listofoptions/Z80-cpu-interposer/nabu processor interposer.kicad_pcb

## KiCad design nabu processor interposer.kicad_pcb (2022-12-26)

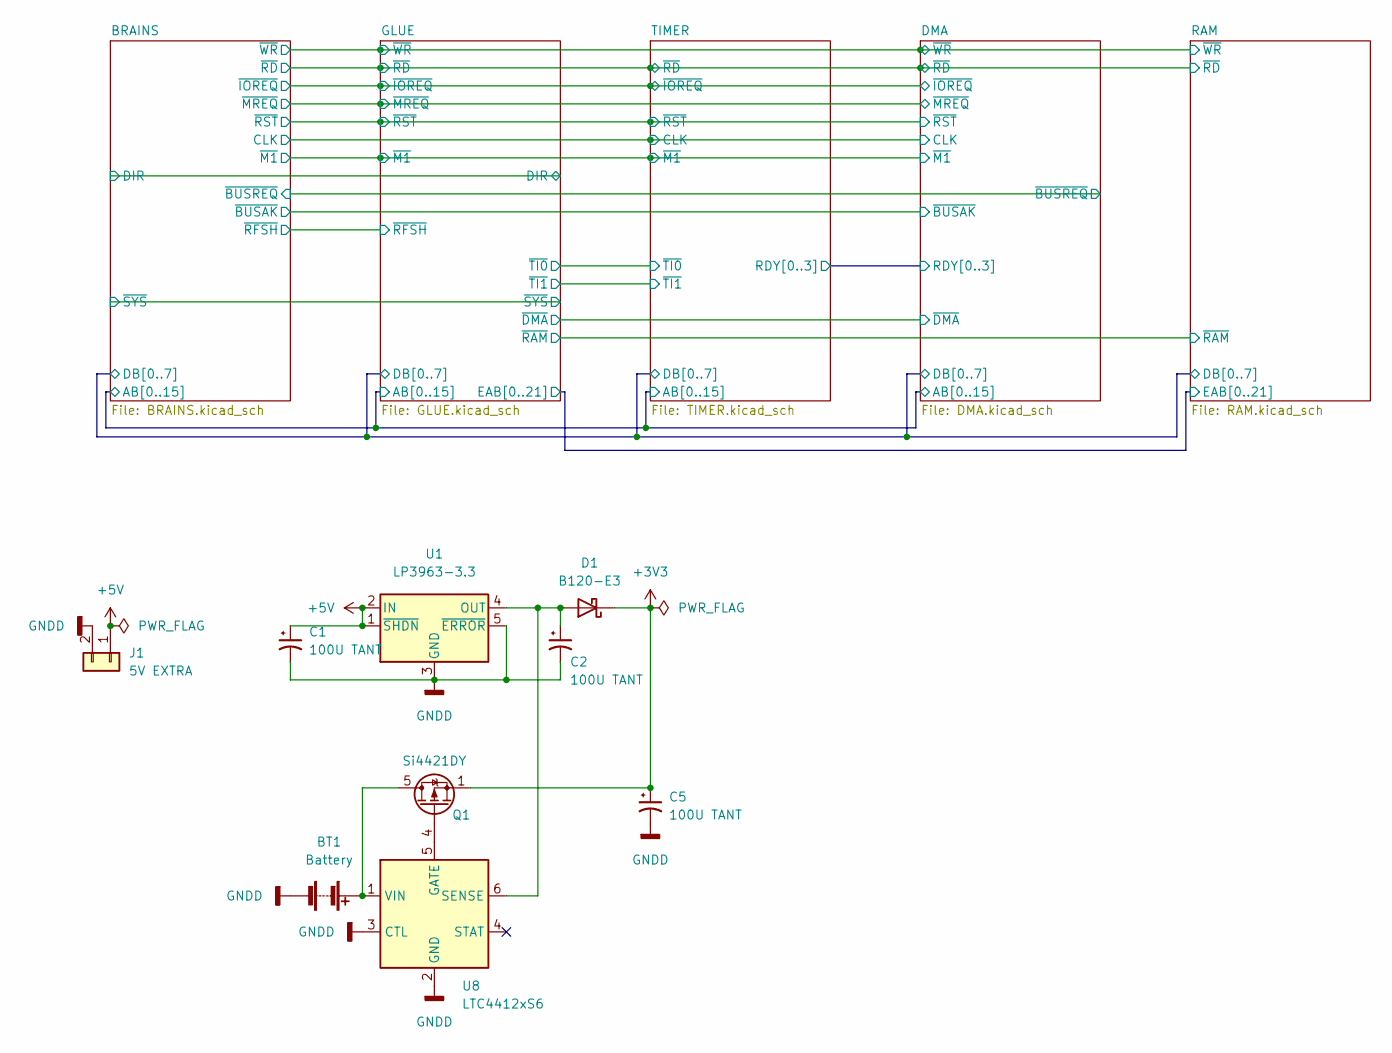
[picture p1: schematic nabu processor interposer.kicad_sch, Z80 CPU INTERPOSER]

Parts:
BT1: Battery; BatteryHolder_Keystone_2462_2xAA
C1, C2, C5: 100U TANT; CP_EIA-3528-15_AVX-H
D1: B120-E3; D_SMA
J1: 5V EXTRA; PinHeader_1x02_P2.54mm_Vertical
Q1: Si4421DY; SO-8_3.9x4.9mm_P1.27mm
U1: LP3963-3.3; TO-263-5_TabPin3
U8: LTC4412xS6; TSOT-23-6

Connections:
+3V3: C5.1, D1.1 (K), Q1.1 (S), Q1.2, Q1.3; also elsewhere on the board
+5V: C1.1, J1.1, U1.1 (~SHDN), U1.2 (IN); also elsewhere on the board
GND: BT1.2 (-), C1.2, C2.2, C5.2, J1.2, U1.3 (GND), U1.5 (~ERROR), U8.2 (GND), U8.3 (CTL); also elsewhere on the board
unnamed: BT1.1 (+), Q1.5 (D), Q1.6, Q1.7, Q1.8, U8.1 (VIN)
unnamed: C2.1, D1.2 (A), U1.4 (OUT), U8.6 (SENSE)
unnamed: Q1.4 (G), U8.5 (GATE)

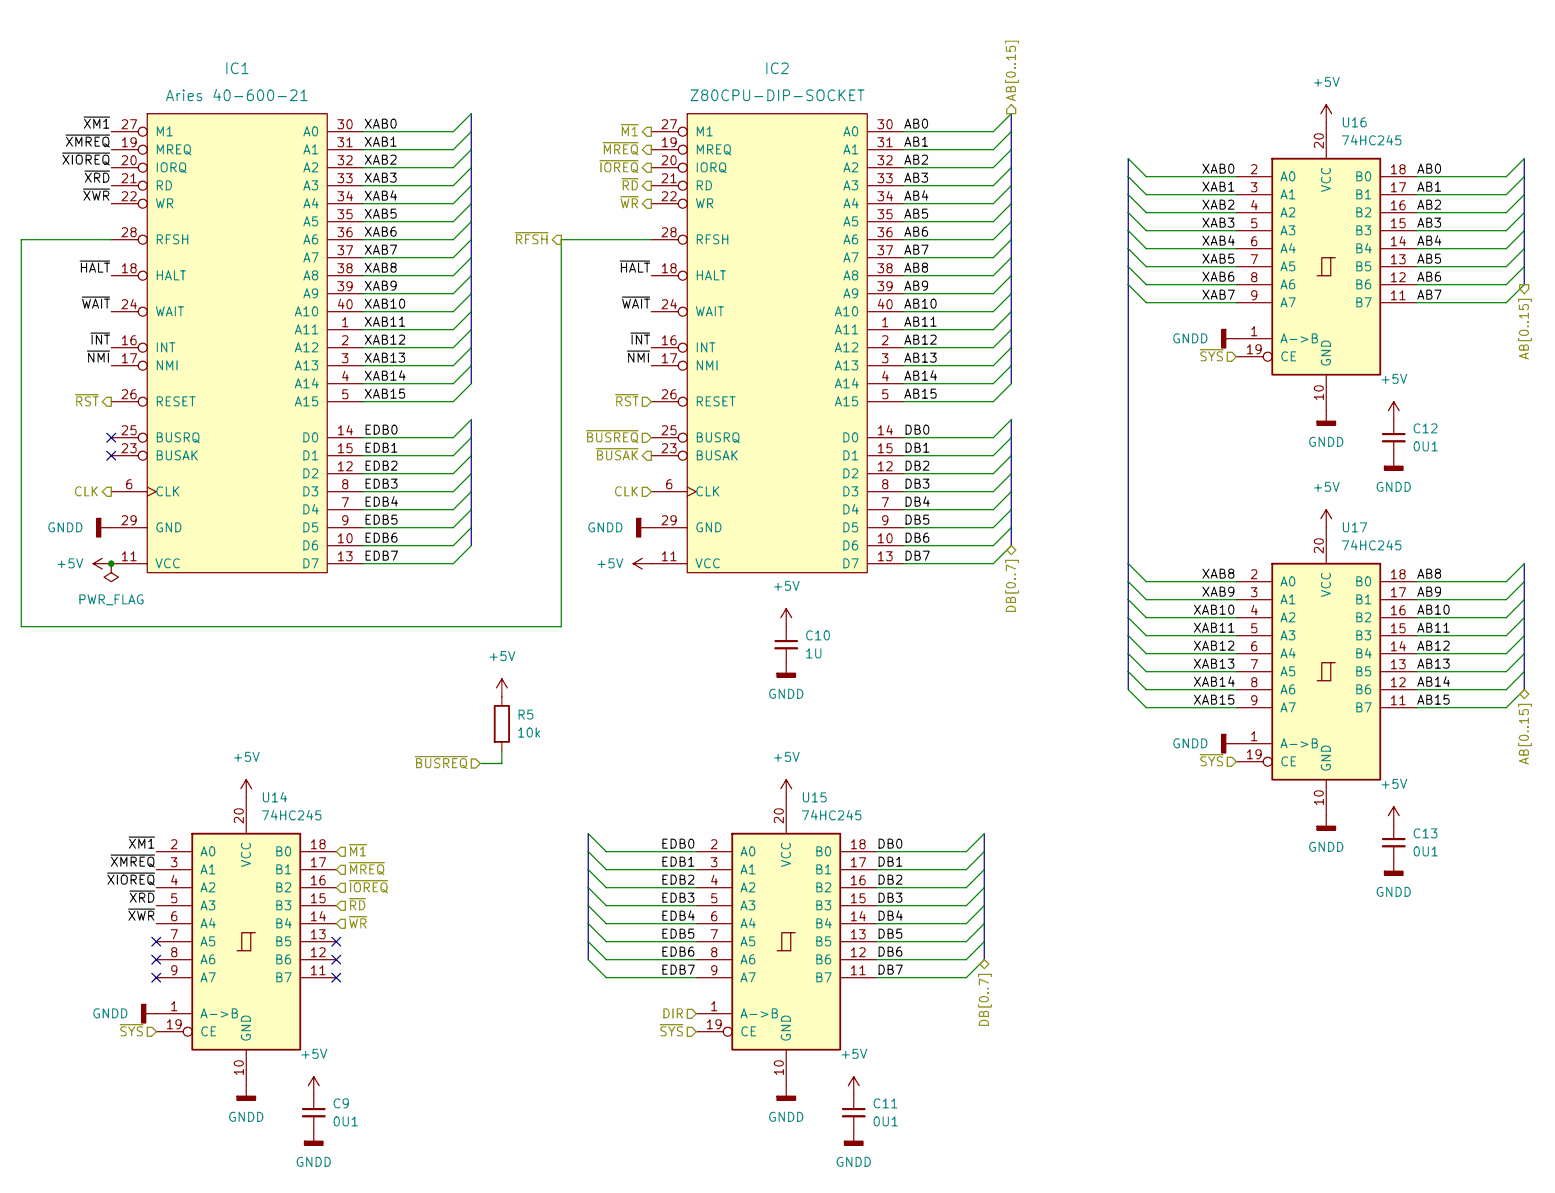
[picture p2: schematic BRAINS.kicad_sch, Z80 CPU INTERPOSER CPU AND PIN CONNECTOR]

Parts:
C9, C11, C12, C13: 0U1; C_1206_3216Metric
C10: 1U; C_1206_3216Metric
IC1: Aries 40-600-21; DIP-40_W15.24mm_Socket
IC2: Z80CPU-DIP-SOCKET; DIP-40_W15.24mm_Socket
R5: 10k; R_0603_1608Metric
U14, U15, U16, U17: 74HC245; TSSOP-20_4.4x6.5mm_P0.65mm

Connections:
+5V: C9.1, C10.1, C11.1, C12.1, C13.1, IC1.11 (VCC), IC2.11 (VCC), R5.1, U14.20 (VCC), U15.20 (VCC), U16.20 (VCC), U17.20 (VCC); also elsewhere on the board
/BRAINS/AB0: IC2.30 (A0), U16.18 (B0); also elsewhere on the board
/BRAINS/AB1: IC2.31 (A1), U16.17 (B1); also elsewhere on the board
/BRAINS/AB2: IC2.32 (A2), U16.16 (B2); also elsewhere on the board
/BRAINS/AB3: IC2.33 (A3), U16.15 (B3); also elsewhere on the board
/BRAINS/AB4: IC2.34 (A4), U16.14 (B4); also elsewhere on the board
/BRAINS/AB5: IC2.35 (A5), U16.13 (B5); also elsewhere on the board
/BRAINS/AB6: IC2.36 (A6), U16.12 (B6); also elsewhere on the board
/BRAINS/AB7: IC2.37 (A7), U16.11 (B7); also elsewhere on the board
/BRAINS/AB8: IC2.38 (A8), U17.18 (B0); also elsewhere on the board
/BRAINS/AB9: IC2.39 (A9), U17.17 (B1); also elsewhere on the board
/BRAINS/AB10: IC2.40 (A10), U17.16 (B2); also elsewhere on the board
/BRAINS/AB11: IC2.1 (A11), U17.15 (B3); also elsewhere on the board
/BRAINS/AB12: IC2.2 (A12), U17.14 (B4); also elsewhere on the board
/BRAINS/AB13: IC2.3 (A13), U17.13 (B5); also elsewhere on the board
/BRAINS/AB14: IC2.4 (A14), U17.12 (B6); also elsewhere on the board
/BRAINS/AB15: IC2.5 (A15), U17.11 (B7); also elsewhere on the board
/BRAINS/CLK: IC1.6 (CLK), IC2.6 (CLK); also elsewhere on the board
/BRAINS/DB0: IC2.14 (D0), U15.18 (B0); also elsewhere on the board
/BRAINS/DB1: IC2.15 (D1), U15.17 (B1); also elsewhere on the board
/BRAINS/DB2: IC2.12 (D2), U15.16 (B2); also elsewhere on the board
/BRAINS/DB3: IC2.8 (D3), U15.15 (B3); also elsewhere on the board
/BRAINS/DB4: IC2.7 (D4), U15.14 (B4); also elsewhere on the board
/BRAINS/DB5: IC2.9 (D5), U15.13 (B5); also elsewhere on the board
/BRAINS/DB6: IC2.10 (D6), U15.12 (B6); also elsewhere on the board
/BRAINS/DB7: IC2.13 (D7), U15.11 (B7); also elsewhere on the board
/BRAINS/DIR: U15.1 (A->B); also elsewhere on the board
/BRAINS/EDB0: IC1.14 (D0), U15.2 (A0)
/BRAINS/EDB1: IC1.15 (D1), U15.3 (A1)
/BRAINS/EDB2: IC1.12 (D2), U15.4 (A2)
/BRAINS/EDB3: IC1.8 (D3), U15.5 (A3)
/BRAINS/EDB4: IC1.7 (D4), U15.6 (A4)
/BRAINS/EDB5: IC1.9 (D5), U15.7 (A5)
/BRAINS/EDB6: IC1.10 (D6), U15.8 (A6)
/BRAINS/EDB7: IC1.13 (D7), U15.9 (A7)
/BRAINS/XAB0: IC1.30 (A0), U16.2 (A0)
/BRAINS/XAB1: IC1.31 (A1), U16.3 (A1)
/BRAINS/XAB2: IC1.32 (A2), U16.4 (A2)
/BRAINS/XAB3: IC1.33 (A3), U16.5 (A3)
/BRAINS/XAB4: IC1.34 (A4), U16.6 (A4)
/BRAINS/XAB5: IC1.35 (A5), U16.7 (A5)
/BRAINS/XAB6: IC1.36 (A6), U16.8 (A6)
/BRAINS/XAB7: IC1.37 (A7), U16.9 (A7)
/BRAINS/XAB8: IC1.38 (A8), U17.2 (A0)
/BRAINS/XAB9: IC1.39 (A9), U17.3 (A1)
/BRAINS/XAB10: IC1.40 (A10), U17.4 (A2)
/BRAINS/XAB11: IC1.1 (A11), U17.5 (A3)
/BRAINS/XAB12: IC1.2 (A12), U17.6 (A4)
/BRAINS/XAB13: IC1.3 (A13), U17.7 (A5)
/BRAINS/XAB14: IC1.4 (A14), U17.8 (A6)
/BRAINS/XAB15: IC1.5 (A15), U17.9 (A7)
/BRAINS/~BUSAK: IC2.23 (BUSAK); also elsewhere on the board
/BRAINS/~BUSREQ: IC2.25 (BUSRQ), R5.2; also elsewhere on the board
/BRAINS/~HALT: IC1.18 (HALT), IC2.18 (HALT)
/BRAINS/~INT: IC1.16 (INT), IC2.16 (INT)
/BRAINS/~IOREQ: IC2.20 (IORQ), U14.16 (B2); also elsewhere on the board
/BRAINS/~M1: IC2.27 (M1), U14.18 (B0); also elsewhere on the board
/BRAINS/~MREQ: IC2.19 (MREQ), U14.17 (B1); also elsewhere on the board
/BRAINS/~NMI: IC1.17 (NMI), IC2.17 (NMI)
/BRAINS/~RD: IC2.21 (RD), U14.15 (B3); also elsewhere on the board
/BRAINS/~RFSH: IC1.28 (RFSH), IC2.28 (RFSH); also elsewhere on the board
/BRAINS/~RST: IC1.26 (RESET), IC2.26 (RESET); also elsewhere on the board
/BRAINS/~SYS: U14.19 (CE), U15.19 (CE), U16.19 (CE), U17.19 (CE); also elsewhere on the board
/BRAINS/~WAIT: IC1.24 (WAIT), IC2.24 (WAIT)
/BRAINS/~WR: IC2.22 (WR), U14.14 (B4); also elsewhere on the board
/BRAINS/~XIOREQ: IC1.20 (IORQ), U14.4 (A2)
/BRAINS/~XM1: IC1.27 (M1), U14.2 (A0)
/BRAINS/~XMREQ: IC1.19 (MREQ), U14.3 (A1)
/BRAINS/~XRD: IC1.21 (RD), U14.5 (A3)
/BRAINS/~XWR: IC1.22 (WR), U14.6 (A4)
GND: C9.2, C10.2, C11.2, C12.2, C13.2, IC1.29 (GND), IC2.29 (GND), U14.1 (A->B), U14.10 (GND), U15.10 (GND), U16.1 (A->B), U16.10 (GND), U17.1 (A->B), U17.10 (GND); also elsewhere on the board

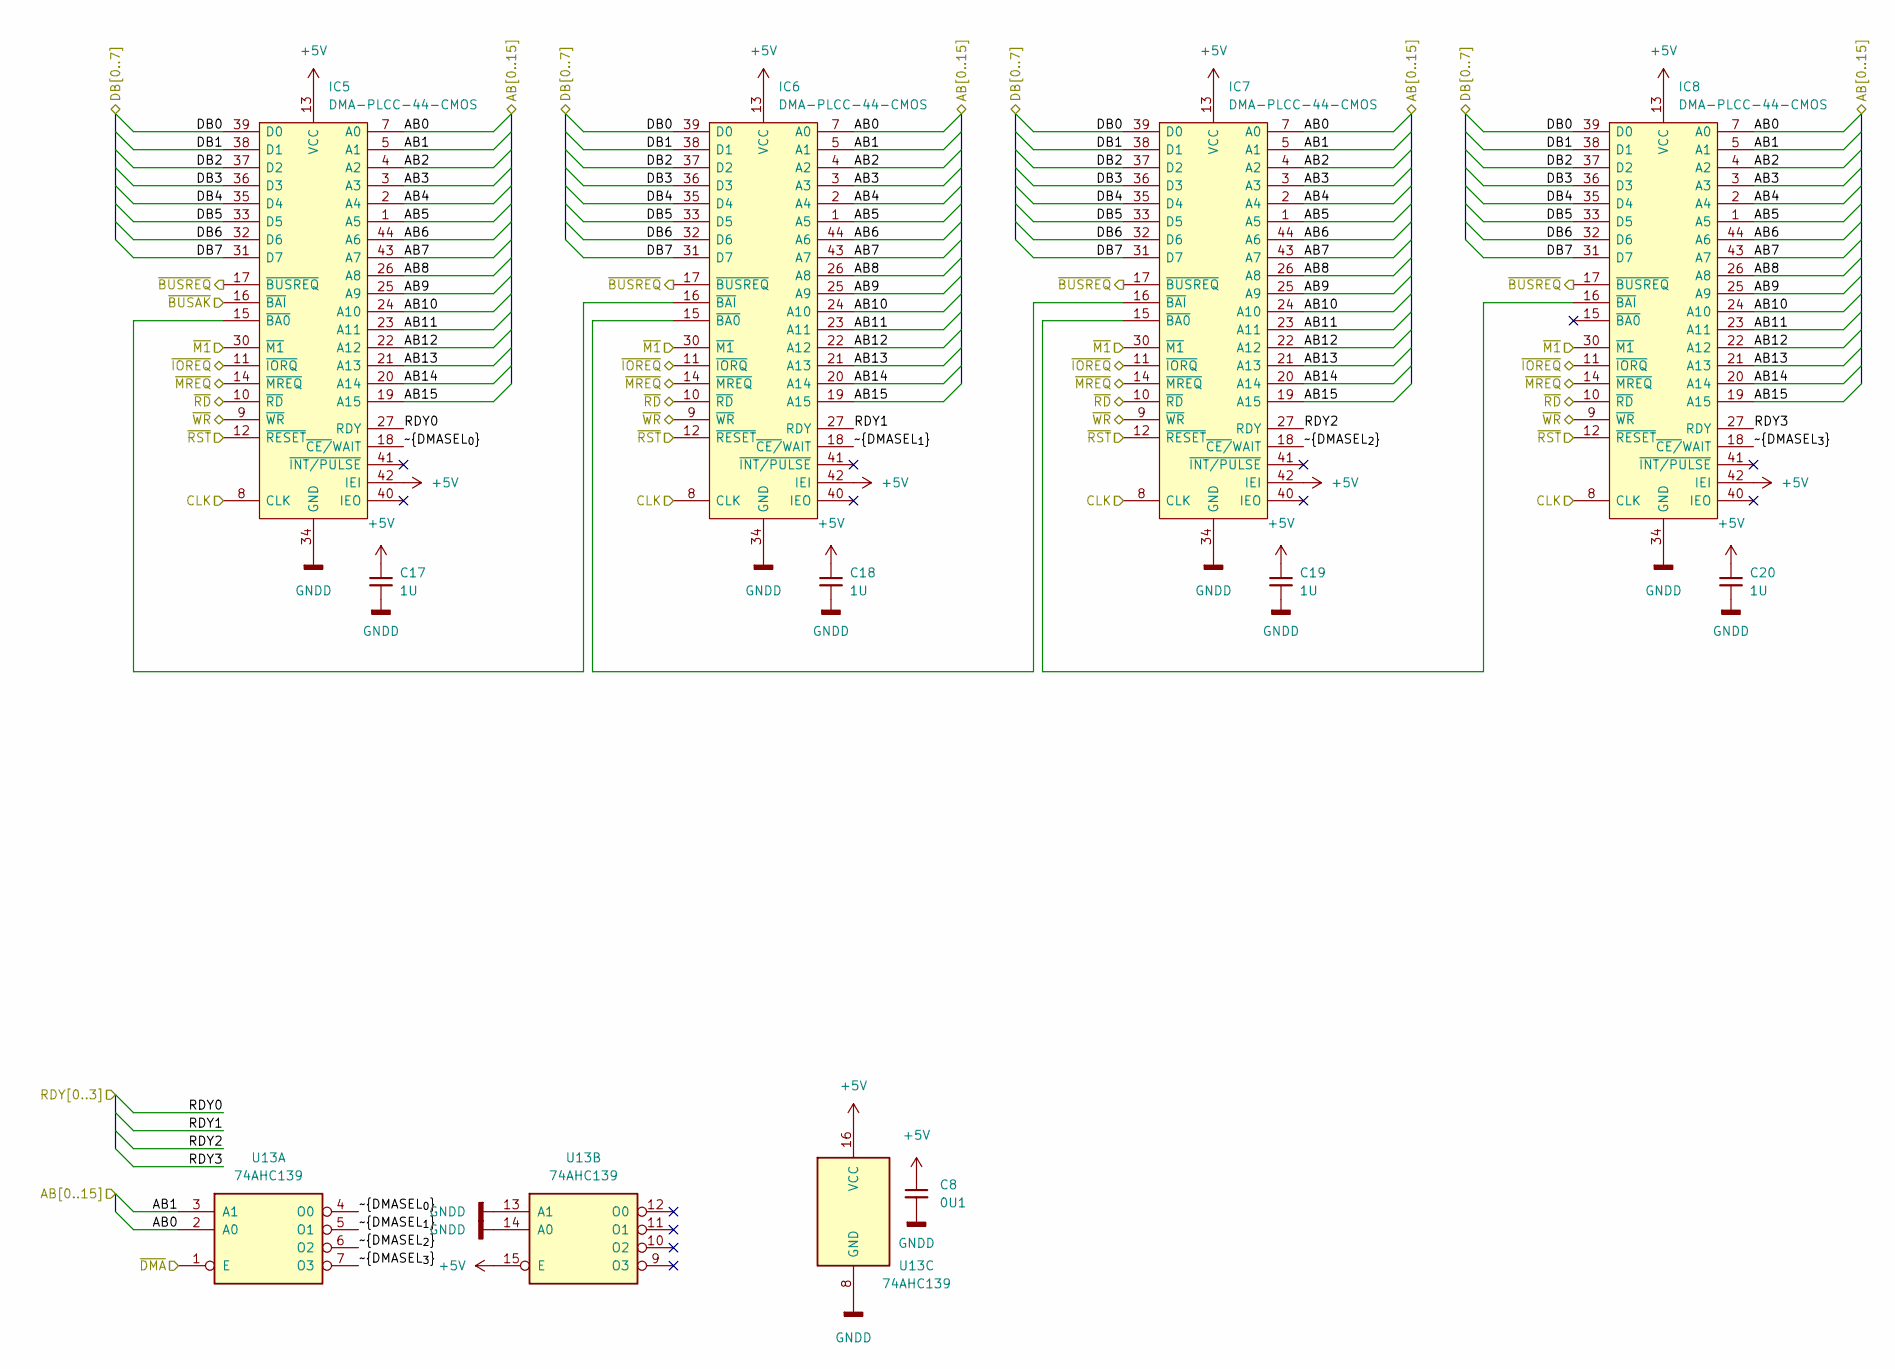
[picture p3: schematic DMA.kicad_sch, Z80 CPU INTERPOSER DMA AND DMA CONTROL]

Parts:
C8: 0U1; C_0603_1608Metric
C17, C18, C19, C20: 1U; C_1206_3216Metric
IC5, IC6, IC7, IC8: DMA-PLCC-44-CMOS; LQFP-44_10x10mm_P0.8mm; Manufacturer_Part_Number Z84C4206PEG; Mouser Part Number 692-Z84C4206PEG
U13: 74AHC139; TSSOP-16_4.4x5mm_P0.65mm

Connections:
+5V: C8.1, C17.1, C18.1, C19.1, C20.1, IC5.13 (VCC), IC5.42 (IEI), IC6.13 (VCC), IC6.42 (IEI), IC7.13 (VCC), IC7.42 (IEI), IC8.13 (VCC), IC8.42 (IEI), U13.15 (E), U13.16 (VCC); also elsewhere on the board
/BRAINS/AB0: IC5.7 (A0), IC6.7 (A0), IC7.7 (A0), IC8.7 (A0), U13.2 (A0); also elsewhere on the board
/BRAINS/AB1: IC5.5 (A1), IC6.5 (A1), IC7.5 (A1), IC8.5 (A1), U13.3 (A1); also elsewhere on the board
/BRAINS/AB2: IC5.4 (A2), IC6.4 (A2), IC7.4 (A2), IC8.4 (A2); also elsewhere on the board
/BRAINS/AB3: IC5.3 (A3), IC6.3 (A3), IC7.3 (A3), IC8.3 (A3); also elsewhere on the board
/BRAINS/AB4: IC5.2 (A4), IC6.2 (A4), IC7.2 (A4), IC8.2 (A4); also elsewhere on the board
/BRAINS/AB5: IC5.1 (A5), IC6.1 (A5), IC7.1 (A5), IC8.1 (A5); also elsewhere on the board
/BRAINS/AB6: IC5.44 (A6), IC6.44 (A6), IC7.44 (A6), IC8.44 (A6); also elsewhere on the board
/BRAINS/AB7: IC5.43 (A7), IC6.43 (A7), IC7.43 (A7), IC8.43 (A7); also elsewhere on the board
/BRAINS/AB8: IC5.26 (A8), IC6.26 (A8), IC7.26 (A8), IC8.26 (A8); also elsewhere on the board
/BRAINS/AB9: IC5.25 (A9), IC6.25 (A9), IC7.25 (A9), IC8.25 (A9); also elsewhere on the board
/BRAINS/AB10: IC5.24 (A10), IC6.24 (A10), IC7.24 (A10), IC8.24 (A10); also elsewhere on the board
/BRAINS/AB11: IC5.23 (A11), IC6.23 (A11), IC7.23 (A11), IC8.23 (A11); also elsewhere on the board
/BRAINS/AB12: IC5.22 (A12), IC6.22 (A12), IC7.22 (A12), IC8.22 (A12); also elsewhere on the board
/BRAINS/AB13: IC5.21 (A13), IC6.21 (A13), IC7.21 (A13), IC8.21 (A13); also elsewhere on the board
/BRAINS/AB14: IC5.20 (A14), IC6.20 (A14), IC7.20 (A14), IC8.20 (A14); also elsewhere on the board
/BRAINS/AB15: IC5.19 (A15), IC6.19 (A15), IC7.19 (A15), IC8.19 (A15); also elsewhere on the board
/BRAINS/CLK: IC5.8 (CLK), IC6.8 (CLK), IC7.8 (CLK), IC8.8 (CLK); also elsewhere on the board
/BRAINS/DB0: IC5.39 (D0), IC6.39 (D0), IC7.39 (D0), IC8.39 (D0); also elsewhere on the board
/BRAINS/DB1: IC5.38 (D1), IC6.38 (D1), IC7.38 (D1), IC8.38 (D1); also elsewhere on the board
/BRAINS/DB2: IC5.37 (D2), IC6.37 (D2), IC7.37 (D2), IC8.37 (D2); also elsewhere on the board
/BRAINS/DB3: IC5.36 (D3), IC6.36 (D3), IC7.36 (D3), IC8.36 (D3); also elsewhere on the board
/BRAINS/DB4: IC5.35 (D4), IC6.35 (D4), IC7.35 (D4), IC8.35 (D4); also elsewhere on the board
/BRAINS/DB5: IC5.33 (D5), IC6.33 (D5), IC7.33 (D5), IC8.33 (D5); also elsewhere on the board
/BRAINS/DB6: IC5.32 (D6), IC6.32 (D6), IC7.32 (D6), IC8.32 (D6); also elsewhere on the board
/BRAINS/DB7: IC5.31 (D7), IC6.31 (D7), IC7.31 (D7), IC8.31 (D7); also elsewhere on the board
/BRAINS/~BUSAK: IC5.16 (~BAI); also elsewhere on the board
/BRAINS/~BUSREQ: IC5.17 (~BUSREQ), IC6.17 (~BUSREQ), IC7.17 (~BUSREQ), IC8.17 (~BUSREQ); also elsewhere on the board
/BRAINS/~IOREQ: IC5.11 (~IORQ), IC6.11 (~IORQ), IC7.11 (~IORQ), IC8.11 (~IORQ); also elsewhere on the board
/BRAINS/~M1: IC5.30 (~M1), IC6.30 (~M1), IC7.30 (~M1), IC8.30 (~M1); also elsewhere on the board
/BRAINS/~MREQ: IC5.14 (~MREQ), IC6.14 (~MREQ), IC7.14 (~MREQ), IC8.14 (~MREQ); also elsewhere on the board
/BRAINS/~RD: IC5.10 (~RD), IC6.10 (~RD), IC7.10 (~RD), IC8.10 (~RD); also elsewhere on the board
/BRAINS/~RST: IC5.12 (~RESET), IC6.12 (~RESET), IC7.12 (~RESET), IC8.12 (~RESET); also elsewhere on the board
/BRAINS/~WR: IC5.9 (~WR), IC6.9 (~WR), IC7.9 (~WR), IC8.9 (~WR); also elsewhere on the board
/DMA/RDY0: IC5.27 (RDY); also elsewhere on the board
/DMA/RDY1: IC6.27 (RDY); also elsewhere on the board
/DMA/RDY2: IC7.27 (RDY); also elsewhere on the board
/DMA/RDY3: IC8.27 (RDY); also elsewhere on the board
/DMA/~DMASEL_{0}: IC5.18 (~CE/WAIT), U13.4 (O0)
/DMA/~DMASEL_{1}: IC6.18 (~CE/WAIT), U13.5 (O1)
/DMA/~DMASEL_{2}: IC7.18 (~CE/WAIT), U13.6 (O2)
/DMA/~DMASEL_{3}: IC8.18 (~CE/WAIT), U13.7 (O3)
/DMA/~DMA: U13.1 (E); also elsewhere on the board
GND: C8.2, C17.2, C18.2, C19.2, C20.2, IC5.34 (GND), IC6.34 (GND), IC7.34 (GND), IC8.34 (GND), U13.8 (GND), U13.13 (A1), U13.14 (A0); also elsewhere on the board
unnamed: IC5.15 (~BA0), IC6.16 (~BAI)
unnamed: IC6.15 (~BA0), IC7.16 (~BAI)
unnamed: IC7.15 (~BA0), IC8.16 (~BAI)

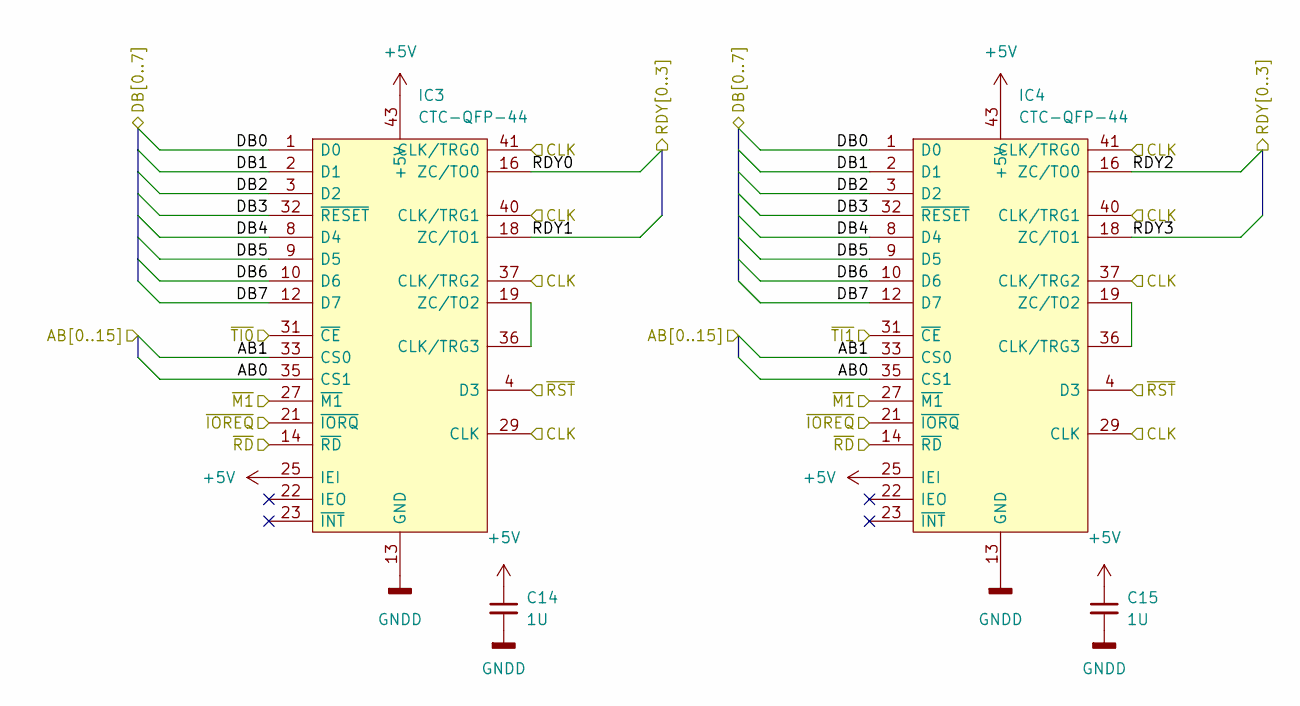
[picture p4: schematic TIMER.kicad_sch, Z80 CPU INTERPOSER DMA AND DMA CONTROL]

Parts:
C14, C15: 1U; C_1206_3216Metric
IC3, IC4: CTC-QFP-44; LQFP-44_10x10mm_P0.8mm; Manufacturer_Part_Number Z84C3010PEG; Mouser Part Number 692-Z84C3010PEG

Connections:
+5V: C14.1, C15.1, IC3.25 (IEI), IC3.43 (+5V), IC4.25 (IEI), IC4.43 (+5V); also elsewhere on the board
/BRAINS/AB0: IC3.35 (CS1), IC4.35 (CS1); also elsewhere on the board
/BRAINS/AB1: IC3.33 (CS0), IC4.33 (CS0); also elsewhere on the board
/BRAINS/CLK: IC3.29 (CLK), IC3.37 (CLK/TRG2), IC3.40 (CLK/TRG1), IC3.41 (CLK/TRG0), IC4.29 (CLK), IC4.37 (CLK/TRG2), IC4.40 (CLK/TRG1), IC4.41 (CLK/TRG0); also elsewhere on the board
/BRAINS/DB0: IC3.1 (D0), IC4.1 (D0); also elsewhere on the board
/BRAINS/DB1: IC3.2 (D1), IC4.2 (D1); also elsewhere on the board
/BRAINS/DB2: IC3.3 (D2), IC4.3 (D2); also elsewhere on the board
/BRAINS/DB3: IC3.32 (~RESET), IC4.32 (~RESET); also elsewhere on the board
/BRAINS/DB4: IC3.8 (D4), IC4.8 (D4); also elsewhere on the board
/BRAINS/DB5: IC3.9 (D5), IC4.9 (D5); also elsewhere on the board
/BRAINS/DB6: IC3.10 (D6), IC4.10 (D6); also elsewhere on the board
/BRAINS/DB7: IC3.12 (D7), IC4.12 (D7); also elsewhere on the board
/BRAINS/~IOREQ: IC3.21 (~IORQ), IC4.21 (~IORQ); also elsewhere on the board
/BRAINS/~M1: IC3.27 (~M1), IC4.27 (~M1); also elsewhere on the board
/BRAINS/~RD: IC3.14 (~RD), IC4.14 (~RD); also elsewhere on the board
/BRAINS/~RST: IC3.4 (D3), IC4.4 (D3); also elsewhere on the board
/DMA/RDY0: IC3.16 (ZC/TO0); also elsewhere on the board
/DMA/RDY1: IC3.18 (ZC/TO1); also elsewhere on the board
/DMA/RDY2: IC4.16 (ZC/TO0); also elsewhere on the board
/DMA/RDY3: IC4.18 (ZC/TO1); also elsewhere on the board
/GLUE/~TI0: IC3.31 (~CE); also elsewhere on the board
/GLUE/~TI1: IC4.31 (~CE); also elsewhere on the board
GND: C14.2, C15.2, IC3.13 (GND), IC4.13 (GND); also elsewhere on the board
unnamed: IC3.19 (ZC/TO2), IC3.36 (CLK/TRG3)
unnamed: IC4.19 (ZC/TO2), IC4.36 (CLK/TRG3)

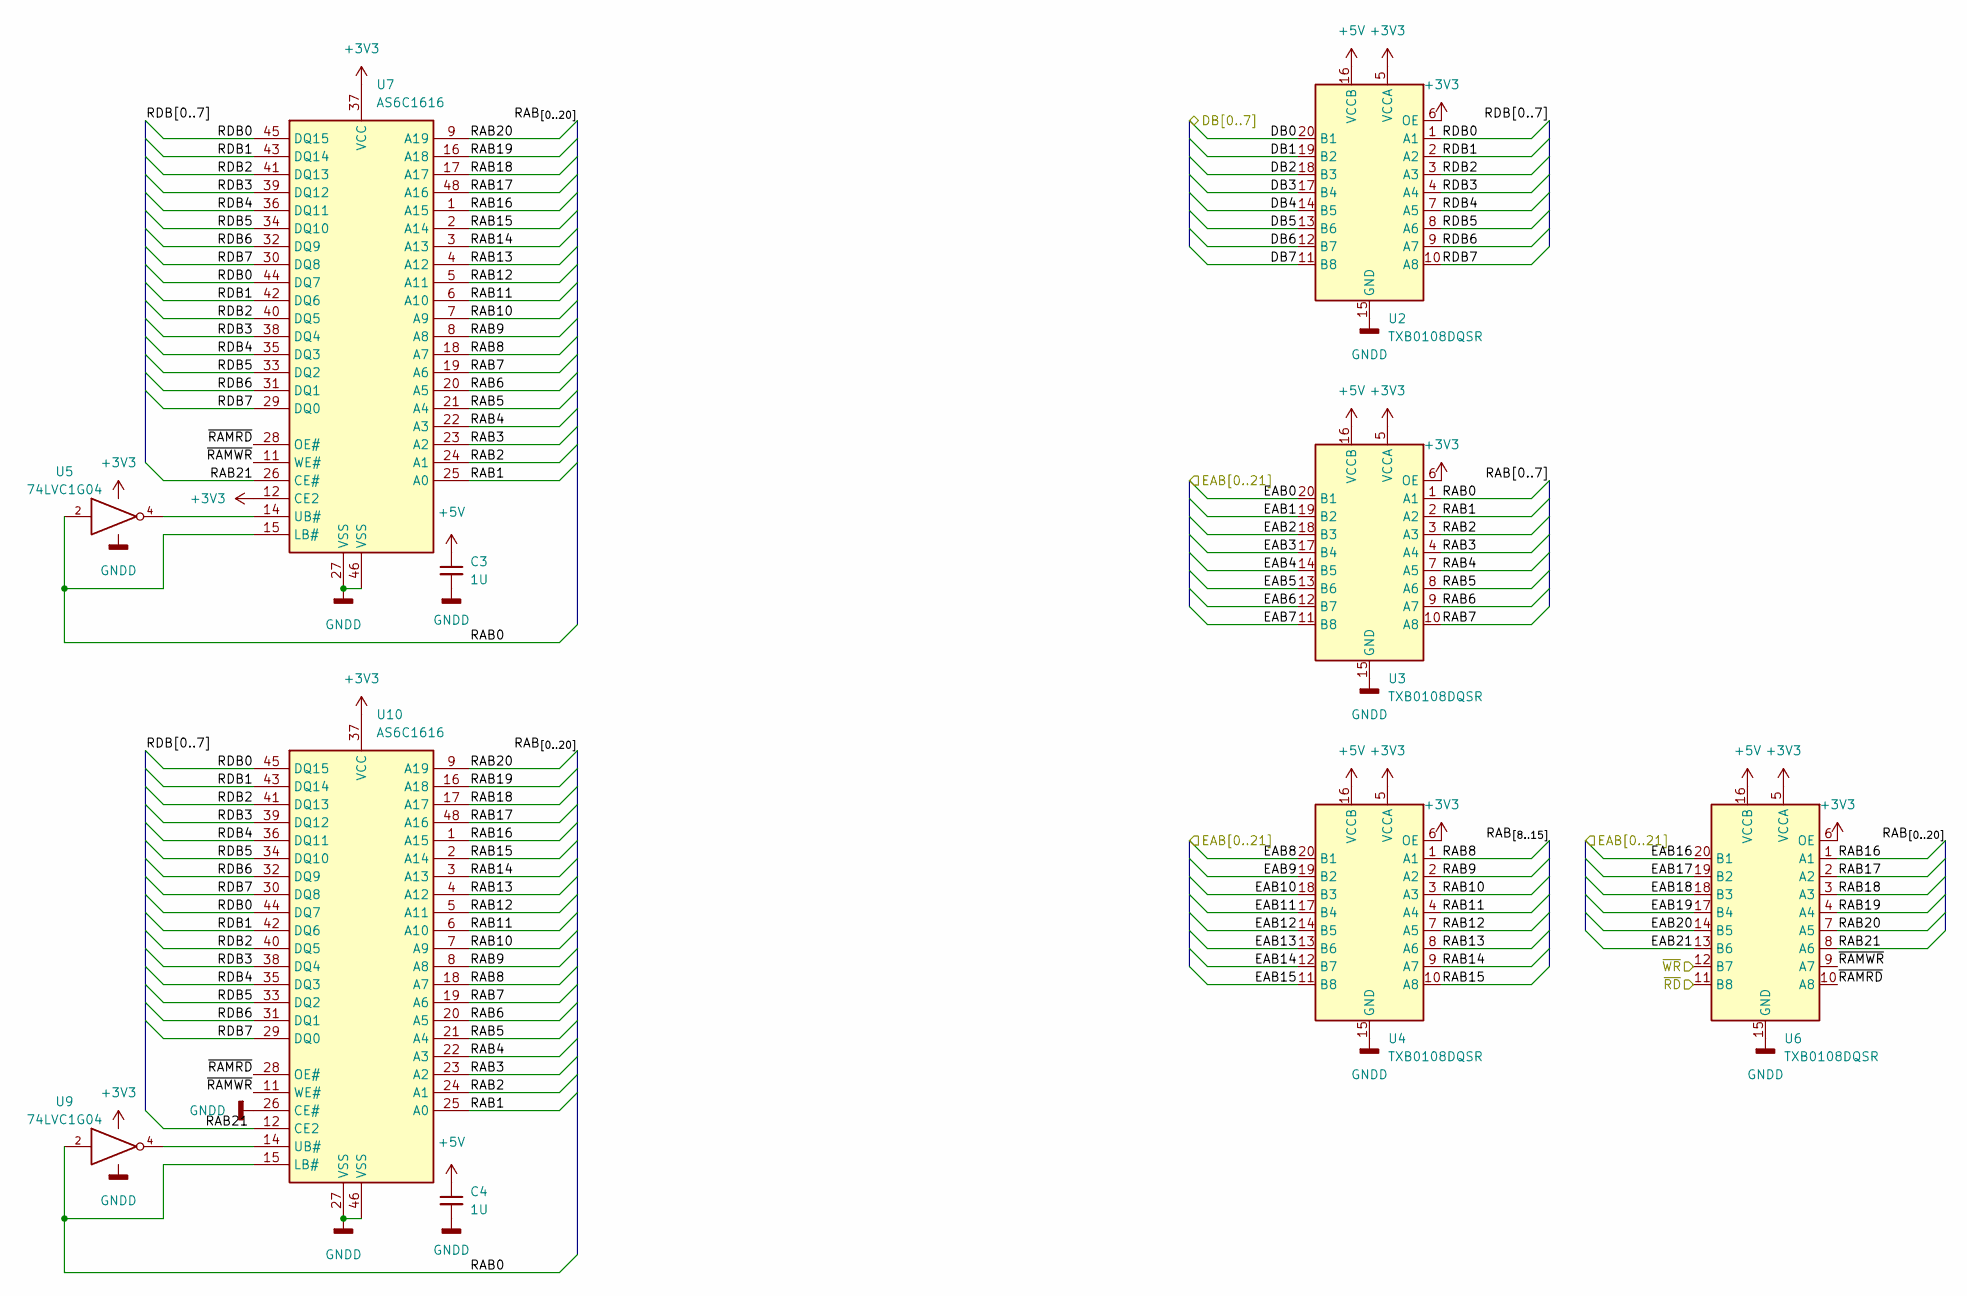
[picture p5: schematic RAM.kicad_sch, Z80 CPU INTERPOSER RAM]

Parts:
C3, C4: 1U; C_1206_3216Metric
U2, U3, U4, U6: TXB0108DQSR; USON-20_2x4mm_P0.4mm
U5, U9: 74LVC1G04; SOT-353_SC-70-5
U7, U10: AS6C1616; TSOP-I-48_18.4x12mm_P0.5mm

Connections:
+3V3: U2.5 (VCCA), U2.6 (OE), U3.5 (VCCA), U3.6 (OE), U4.5 (VCCA), U4.6 (OE), U5.5 (VCC), U6.5 (VCCA), U6.6 (OE), U7.12 (CE2), U7.37 (VCC), U9.5 (VCC), U10.37 (VCC); also elsewhere on the board
+5V: C3.1, C4.1, U2.16 (VCCB), U3.16 (VCCB), U4.16 (VCCB), U6.16 (VCCB); also elsewhere on the board
/BRAINS/AB0: U3.20 (B1); also elsewhere on the board
/BRAINS/AB1: U3.19 (B2); also elsewhere on the board
/BRAINS/AB2: U3.18 (B3); also elsewhere on the board
/BRAINS/AB3: U3.17 (B4); also elsewhere on the board
/BRAINS/AB4: U3.14 (B5); also elsewhere on the board
/BRAINS/AB5: U3.13 (B6); also elsewhere on the board
/BRAINS/AB6: U3.12 (B7); also elsewhere on the board
/BRAINS/AB7: U3.11 (B8); also elsewhere on the board
/BRAINS/AB8: U4.20 (B1); also elsewhere on the board
/BRAINS/AB9: U4.19 (B2); also elsewhere on the board
/BRAINS/AB10: U4.18 (B3); also elsewhere on the board
/BRAINS/AB11: U4.17 (B4); also elsewhere on the board
/BRAINS/AB12: U4.14 (B5); also elsewhere on the board
/BRAINS/AB13: U4.13 (B6); also elsewhere on the board
/BRAINS/DB0: U2.20 (B1); also elsewhere on the board
/BRAINS/DB1: U2.19 (B2); also elsewhere on the board
/BRAINS/DB2: U2.18 (B3); also elsewhere on the board
/BRAINS/DB3: U2.17 (B4); also elsewhere on the board
/BRAINS/DB4: U2.14 (B5); also elsewhere on the board
/BRAINS/DB5: U2.13 (B6); also elsewhere on the board
/BRAINS/DB6: U2.12 (B7); also elsewhere on the board
/BRAINS/DB7: U2.11 (B8); also elsewhere on the board
/BRAINS/~RD: U6.11 (B8); also elsewhere on the board
/BRAINS/~WR: U6.12 (B7); also elsewhere on the board
/GLUE/EAB14: U4.12 (B7); also elsewhere on the board
/GLUE/EAB15: U4.11 (B8); also elsewhere on the board
/GLUE/EAB16: U6.20 (B1); also elsewhere on the board
/GLUE/EAB17: U6.19 (B2); also elsewhere on the board
/GLUE/EAB18: U6.18 (B3); also elsewhere on the board
/GLUE/EAB19: U6.17 (B4); also elsewhere on the board
/GLUE/EAB20: U6.14 (B5); also elsewhere on the board
/GLUE/EAB21: U6.13 (B6); also elsewhere on the board
/RAM/RAB0: U3.1 (A1), U5.2, U7.15 (LB#), U9.2, U10.15 (LB#)
/RAM/RAB1: U3.2 (A2), U7.25 (A0), U10.25 (A0)
/RAM/RAB2: U3.3 (A3), U7.24 (A1), U10.24 (A1)
/RAM/RAB3: U3.4 (A4), U7.23 (A2), U10.23 (A2)
/RAM/RAB4: U3.7 (A5), U7.22 (A3), U10.22 (A3)
/RAM/RAB5: U3.8 (A6), U7.21 (A4), U10.21 (A4)
/RAM/RAB6: U3.9 (A7), U7.20 (A5), U10.20 (A5)
/RAM/RAB7: U3.10 (A8), U7.19 (A6), U10.19 (A6)
/RAM/RAB8: U4.1 (A1), U7.18 (A7), U10.18 (A7)
/RAM/RAB9: U4.2 (A2), U7.8 (A8), U10.8 (A8)
/RAM/RAB10: U4.3 (A3), U7.7 (A9), U10.7 (A9)
/RAM/RAB11: U4.4 (A4), U7.6 (A10), U10.6 (A10)
/RAM/RAB12: U4.7 (A5), U7.5 (A11), U10.5 (A11)
/RAM/RAB13: U4.8 (A6), U7.4 (A12), U10.4 (A12)
/RAM/RAB14: U4.9 (A7), U7.3 (A13), U10.3 (A13)
/RAM/RAB15: U4.10 (A8), U7.2 (A14), U10.2 (A14)
/RAM/RAB16: U6.1 (A1), U7.1 (A15), U10.1 (A15)
/RAM/RAB17: U6.2 (A2), U7.48 (A16), U10.48 (A16)
/RAM/RAB18: U6.3 (A3), U7.17 (A17), U10.17 (A17)
/RAM/RAB19: U6.4 (A4), U7.16 (A18), U10.16 (A18)
/RAM/RAB20: U6.7 (A5), U7.9 (A19), U10.9 (A19)
/RAM/RAB21: U6.8 (A6), U7.26 (CE#), U10.12 (CE2)
/RAM/RDB0: U2.1 (A1), U7.44 (DQ7), U7.45 (DQ15), U10.44 (DQ7), U10.45 (DQ15)
/RAM/RDB1: U2.2 (A2), U7.42 (DQ6), U7.43 (DQ14), U10.42 (DQ6), U10.43 (DQ14)
/RAM/RDB2: U2.3 (A3), U7.40 (DQ5), U7.41 (DQ13), U10.40 (DQ5), U10.41 (DQ13)
/RAM/RDB3: U2.4 (A4), U7.38 (DQ4), U7.39 (DQ12), U10.38 (DQ4), U10.39 (DQ12)
/RAM/RDB4: U2.7 (A5), U7.35 (DQ3), U7.36 (DQ11), U10.35 (DQ3), U10.36 (DQ11)
/RAM/RDB5: U2.8 (A6), U7.33 (DQ2), U7.34 (DQ10), U10.33 (DQ2), U10.34 (DQ10)
/RAM/RDB6: U2.9 (A7), U7.31 (DQ1), U7.32 (DQ9), U10.31 (DQ1), U10.32 (DQ9)
/RAM/RDB7: U2.10 (A8), U7.29 (DQ0), U7.30 (DQ8), U10.29 (DQ0), U10.30 (DQ8)
/RAM/~RAMRD: U6.10 (A8), U7.28 (OE#), U10.28 (OE#)
/RAM/~RAMWR: U6.9 (A7), U7.11 (WE#), U10.11 (WE#)
GND: C3.2, C4.2, U2.15 (GND), U3.15 (GND), U4.15 (GND), U5.3 (GND), U6.15 (GND), U7.27 (VSS), U7.46 (VSS), U9.3 (GND), U10.26 (CE#), U10.27 (VSS), U10.46 (VSS); also elsewhere on the board
unnamed: U5.4, U7.14 (UB#)
unnamed: U9.4, U10.14 (UB#)
