listofoptions/Z80-cpu-interposer/nabu processor interposer.kicad_pcb

## KiCad design nabu processor interposer.kicad_pcb (continued)

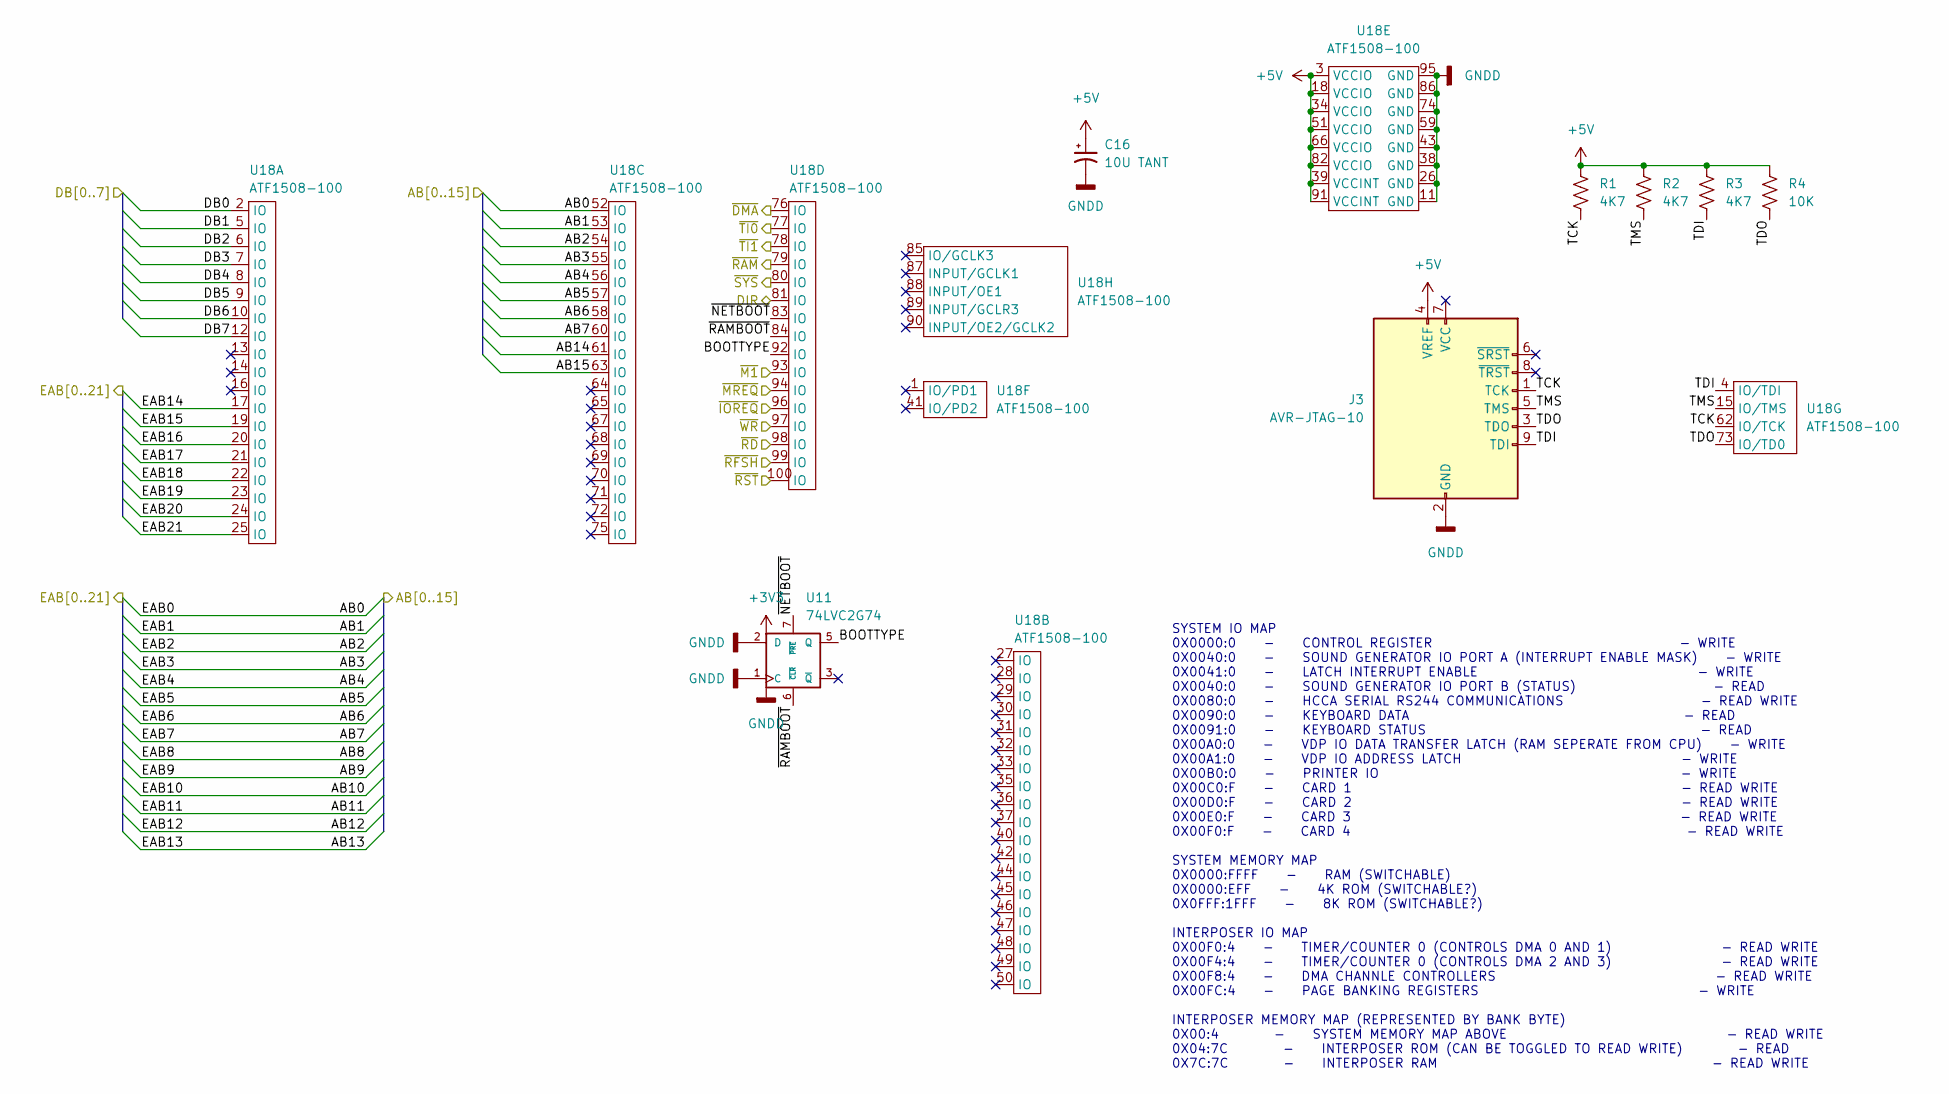
[picture p6: schematic GLUE.kicad_sch, Z80 CPU INTERPOSER IO AND MEMORY ADDRESS DECODE]

Parts:
C16: 10U TANT; CP_EIA-3528-15_AVX-H
J3: AVR-JTAG-10; IDC-Header_2x05_P2.54mm_Horizontal
R1, R2, R3: 4K7; R_0603_1608Metric
R4: 10K; R_0603_1608Metric
U11: 74LVC2G74; SOT-363_SC-70-6
U18: ATF1508-100; TQFP-144_16x16mm_P0.4mm

Connections:
+5V: C16.1, J3.4 (VREF), R1.1, R2.1, R3.1, R4.1, U18.3 (VCCIO), U18.18 (VCCIO), U18.34 (VCCIO), U18.39 (VCCINT), U18.51 (VCCIO), U18.66 (VCCIO), U18.82 (VCCIO), U18.91 (VCCINT); also elsewhere on the board
/BRAINS/AB0: U18.52 (IO); also elsewhere on the board
/BRAINS/AB1: U18.53 (IO); also elsewhere on the board
/BRAINS/AB2: U18.54 (IO); also elsewhere on the board
/BRAINS/AB3: U18.55 (IO); also elsewhere on the board
/BRAINS/AB4: U18.56 (IO); also elsewhere on the board
/BRAINS/AB5: U18.57 (IO); also elsewhere on the board
/BRAINS/AB6: U18.58 (IO); also elsewhere on the board
/BRAINS/AB7: U18.60 (IO); also elsewhere on the board
/BRAINS/AB14: U18.61 (IO); also elsewhere on the board
/BRAINS/AB15: U18.63 (IO); also elsewhere on the board
/BRAINS/DB0: U18.2 (IO); also elsewhere on the board
/BRAINS/DB1: U18.5 (IO); also elsewhere on the board
/BRAINS/DB2: U18.6 (IO); also elsewhere on the board
/BRAINS/DB3: U18.7 (IO); also elsewhere on the board
/BRAINS/DB4: U18.8 (IO); also elsewhere on the board
/BRAINS/DB5: U18.9 (IO); also elsewhere on the board
/BRAINS/DB6: U18.10 (IO); also elsewhere on the board
/BRAINS/DB7: U18.12 (IO); also elsewhere on the board
/BRAINS/DIR: U18.81 (IO); also elsewhere on the board
/BRAINS/~IOREQ: U18.96 (IO); also elsewhere on the board
/BRAINS/~M1: U18.93 (IO); also elsewhere on the board
/BRAINS/~MREQ: U18.94 (IO); also elsewhere on the board
/BRAINS/~RD: U18.98 (IO); also elsewhere on the board
/BRAINS/~RFSH: U18.99 (IO); also elsewhere on the board
/BRAINS/~RST: U18.100 (IO); also elsewhere on the board
/BRAINS/~SYS: U18.80 (IO); also elsewhere on the board
/BRAINS/~WR: U18.97 (IO); also elsewhere on the board
/DMA/~DMA: U18.76 (IO); also elsewhere on the board
/GLUE/BOOTTYPE: U11.5 (Q), U18.92 (IO)
/GLUE/EAB14: U18.17 (IO); also elsewhere on the board
/GLUE/EAB15: U18.19 (IO); also elsewhere on the board
/GLUE/EAB16: U18.20 (IO); also elsewhere on the board
/GLUE/EAB17: U18.21 (IO); also elsewhere on the board
/GLUE/EAB18: U18.22 (IO); also elsewhere on the board
/GLUE/EAB19: U18.23 (IO); also elsewhere on the board
/GLUE/EAB20: U18.24 (IO); also elsewhere on the board
/GLUE/EAB21: U18.25 (IO); also elsewhere on the board
/GLUE/TCK: J3.1 (TCK), R1.2, U18.62 (IO/TCK)
/GLUE/TDI: J3.9 (TDI), R3.2, U18.4 (IO/TDI)
/GLUE/TDO: J3.3 (TDO), R4.2, U18.73 (IO/TD0)
/GLUE/TMS: J3.5 (TMS), R2.2, U18.15 (IO/TMS)
/GLUE/~NETBOOT: U11.7 (~PRE), U18.83 (IO)
/GLUE/~RAMBOOT: U11.6 (~CLR), U18.84 (IO)
/GLUE/~RAM: U18.79 (IO)
/GLUE/~TI0: U18.77 (IO); also elsewhere on the board
/GLUE/~TI1: U18.78 (IO); also elsewhere on the board
GND: C16.2, J3.2 (GND), J3.10 (GND), U11.1 (C), U11.2 (D), U11.4 (GND), U18.11 (GND), U18.26 (GND), U18.38 (GND), U18.43 (GND), U18.59 (GND), U18.74 (GND), U18.86 (GND), U18.95 (GND); also elsewhere on the board

Notes on the sheet:
SYSTEM IO MAP 0X0000:0 - CONTROL REGISTER - WRITE 0X0040:0 - SOUND GENERATOR IO PORT A (INTERRUPT ENABLE MASK) - WRITE 0X0041:0 - LATCH INTERRUPT ENABLE - WRITE 0X0040:0 - SOUND GENERATOR IO PORT B (STATUS) - READ 0X0080:0 - HCCA SERIAL RS244 COMMUNICATIONS - READ WRITE 0X0090:0 - KEYBOARD DATA - R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

Board: 4 copper layers, 53 parts (26 on the bottom side), 139 nets, no tracks yet.
