listofoptions/Z80-cpu-interposer/(commit log)

2022-10-25 added more notes and documentation
    todo:
    - timing analysis to make sure everything fits in 250nS + hold time/prep time
    - logic analysis to ensure correct functionality (am gonna make dumb mistakes!)
    - board layout
    - physical testing!
    [DEV PORT.kicad_sch, MAPPER.kicad_sch, MUX.kicad_sch, RAM.kicad_sch, RESET.kicad_sch, ROM.kicad_sch, nabu processor interposer.kicad_sch]
2022-10-25 fixed non obvious bug in mapper circuit reset logic, would be possible to have the latches both clocked and reset at the same time!, now only resets when in reset, and only clocks when not in reset
    [MAPPER.kicad_sch, nabu processor interposer.kicad_sch]
2022-10-25 changed bus names to avoid possible conflicts, fixed unnamed busses.
    [MAPPER.kicad_sch, MUX.kicad_sch, RAM.kicad_sch, RESET.kicad_sch, nabu processor interposer.kicad_sch]
2022-10-25 added decoupling capacitors, perhaps too many? idk better more than less!
    [BRAINS.kicad_sch, DECODE.kicad_sch, MAPPER.kicad_sch, MUX.kicad_sch, RAM.kicad_sch, RESET.kicad_sch, ROM.kicad_sch, nabu processor interposer.kicad_sch]
2022-10-26 distrustful of timing on reset of mapping registers
    [MAPPER.kicad_sch, nabu processor interposer.kicad_sch]
2022-10-26 duh obvious optimization
    [MAPPER.kicad_sch, nabu processor interposer.kicad_sch]
2022-10-26 more obvious optimizations
    [ROM.kicad_sch, nabu processor interposer.kicad_sch]
2022-10-26 some clean up and simplification, as well as some renaming
    [BRAINS.kicad_sch, DECODE.kicad_sch, DEV PORT.kicad_sch, DMA.kicad_sch, MAPPER.kicad_sch, MUX.kicad_sch, RAM.kicad_sch, RESET.kicad_sch]
2022-12-03 begin integration of logic into atf1508
    [BRAINS.kicad_sch, DECODE.kicad_sch, DEV PORT.kicad_sch, DMA.kicad_sch, MAPPER.kicad_sch, MUX.kicad_sch, RAM.kicad_sch, RESET.kicad_sch]
2022-12-03 added ATF150x part (specifically the 1508) vhdl file contains the (hopeful) implementition of the mapper
    [BRAINS.kicad_sch, DMA.kicad_sch, GLUE.kicad_sch, RAM.kicad_sch, ROM.kicad_sch, TIMER.kicad_sch, nabu processor interposer.kicad_sch]
2022-12-05 updated 84c10 pinout, apparently never checked for validity.... further simplification of dma and timer system (removed mode 2 interrupt structure, and interrupts in general) cleaned up vhdl code for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
    [BRAINS.kicad_sch, DMA.kicad_sch, GLUE.kicad_sch, RAM.kicad_sch, ROM.kicad_sch, TIMER.kicad_sch, nabu processor interposer.kicad_pcb, nabu processor interposer.kicad_sch]
2022-12-05 forgot to actually add the previous fixes to kicad
    [BRAINS.kicad_sch, DECODE.kicad_sch, DEV PORT.kicad_sch, GLUE.kicad_sch, MAPPER.kicad_sch, MUX.kicad_sch, RAM.kicad_sch, RESET.kicad_sch]
2022-12-07 fixed logic errors (me being dumb forgetting associativity of ops, and fixed write only system databus on interposer
    [BRAINS.kicad_sch, GLUE.kicad_sch, nabu processor interposer.kicad_sch]
2022-12-08 Added R5: a pull-up resistor for the /BUSREQ pin
    [BRAINS.kicad_sch, nabu processor interposer.kicad_pcb, nabu processor interposer.kicad_sch]
2022-12-08 Removed project local settings (.kicad_prl), these are usually not stored with revision control.
2022-12-16 fixed extra nand_reduce (issue #8)
    set default data bus driver direction to 'high' ie to read from the databus
    only, we should be to get away with this since sys_dir should be disabling
    the buffer regaurdless if both rd_n and wr_n are in the inactive states.
    (issue #6)
    fixed a silly mixup in pin driver direction (issue #5)
    pin names changed per request (issue #7) to reflect active low, also when
    refering to pin states perhaps we should use "active" and "inactive" to
    avoid "low" and "high" which have meaning contectutal on the logic type
    [mapper.vhd]
2022-12-16 simplified the vhdl code for the mapper by removing some of the more complex initilization logic used: flags was initially intended to be used for reset logic but was determined to be un-needed if we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
    control_regs was going to shadow the main system control
    register, but only contain the bits not used by the system.
    removed for now since im not sure that those bits arent
    written anyway by software. the eventual intention is to
    allow bits 7 and 8 to determine if mapping is wanted at all
    and to boot from interposer rom instead of network (which may
    end up being done anyway if i can figure out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
    [GLUE.kicad_sch, nabu processor interposer.kicad_pcb]
2022-12-26 final hardware revision
    final update to the hardware:
    - removed flash
    - added battery backup switch-over
    - increased ram to 4MB
    - added ramboot/netboot option by using reads to write-only ports to trigger/toggle
    - fixed a logic bug i should have caught in writes to the mapper registers (using bits 14&15 instead of 1&0)
    [DMA.kicad_sch, GLUE.kicad_sch, RAM.kicad_sch, ROM.kicad_sch, nabu processor interposer.kicad_pcb, nabu processor interposer.kicad_sch]
